WeiCheng14159/VSD_CNN_accelerator/VSD_2021/src/data_array_wrapper.sv

`ifndef __DATAARY__
`define __DATAARY__
module data_array_wrapper (
    input CK,
    input CS,
    input OE,
    input [15:0] WEB,
    input [5:0] A,
    input [127:0] DI,
    output [127:0] DO
);

  data_array i_data_array (
      .A0   (A[0]),
      .A1   (A[1]),
      .A2   (A[2]),
      .A3   (A[3]),
      .A4   (A[4]),
      .A5   (A[5]),
      .DO0  (DO[0]),
      .DO1  (DO[1]),
      .DO2  (DO[2]),
      .DO3  (DO[3]),
      .DO4  (DO[4]),
      .DO5  (DO[5]),
      .DO6  (DO[6]),
      .DO7  (DO[7]),
      .DO8  (DO[8]),
      .DO9  (DO[9]),
      .DO10 (DO[10]),
      .DO11 (DO[11]),
      .DO12 (DO[12]),
      .DO13 (DO[13]),
      .DO14 (DO[14]),
      .DO15 (DO[15]),
      .DO16 (DO[16]),
      .DO17 (DO[17]),
      .DO18 (DO[18]),
      .DO19 (DO[19]),
      .DO20 (DO[20]),
      .DO21 (DO[21]),
      .DO22 (DO[22]),
      .DO23 (DO[23]),
      .DO24 (DO[24]),
      .DO25 (DO[25]),
      .DO26 (DO[26]),
      .DO27 (DO[27]),
      .DO28 (DO[28]),
      .DO29 (DO[29]),
      .DO30 (DO[30]),
      .DO31 (DO[31]),
      .DO32 (DO[32]),
      .DO33 (DO[33]),
      .DO34 (DO[34]),
      .DO35 (DO[35]),
      .DO36 (DO[36]),
      .DO37 (DO[37]),
      .DO38 (DO[38]),
      .DO39 (DO[39]),
      .DO40 (DO[40]),
      .DO41 (DO[41]),
      .DO42 (DO[42]),
      .DO43 (DO[43]),
      .DO44 (DO[44]),
      .DO45 (DO[45]),
      .DO46 (DO[46]),
      .DO47 (DO[47]),
      .DO48 (DO[48]),
      .DO49 (DO[49]),
      .DO50 (DO[50]),
      .DO51 (DO[51]),
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
      .DI114(DI[114]),
      .DI115(DI[115]),
      .DI116(DI[116]),
      .DI117(DI[117]),
      .DI118(DI[118]),
      .DI119(DI[119]),
      .DI120(DI[120]),
      .DI121(DI[121]),
      .DI122(DI[122]),
      .DI123(DI[123]),
      .DI124(DI[124]),
      .DI125(DI[125]),
      .DI126(DI[126]),
      .DI127(DI[127]),
      .CK   (CK),
      .WEB0 (WEB[0]),
      .WEB1 (WEB[1]),
      .WEB2 (WEB[2]),
      .WEB3 (WEB[3]),
      .WEB4 (WEB[4]),
      .WEB5 (WEB[5]),
      .WEB6 (WEB[6]),
      .WEB7 (WEB[7]),
      .WEB8 (WEB[8]),
      .WEB9 (WEB[9]),
      .WEB10(WEB[10]),
      .WEB11(WEB[11]),
      .WEB12(WEB[12]),
      .WEB13(WEB[13]),
      .WEB14(WEB[14]),
      .WEB15(WEB[15]),
      .OE   (OE),
      .CS   (CS)
  );

endmodule
`endif
