WeiCheng14159/VSD_CNN_accelerator/EPU_verify/mem/inout_16b_sram/SUMA180_32768X16X1BM8_rtl.sv

module SUMA180_32768X16X1BM8 (A0,A1,A2,A3,A4,A5,A6,A7,A8,A9,A10,A11,A12,A13,A14,
                              DO0,DO1,DO2,DO3,DO4,DO5,DO6,DO7,DO8,DO9,DO10,
                              DO11,DO12,DO13,DO14,DO15,DI0,DI1,DI2,DI3,
                              DI4,DI5,DI6,DI7,DI8,DI9,DI10,DI11,DI12,DI13,
                              DI14,DI15,CK,WEB,OE, CS);

  output     DO0,DO1,DO2,DO3,DO4,DO5,DO6,DO7,DO8,
             DO9,DO10,DO11,DO12,DO13,DO14,DO15;
  input      DI0,DI1,DI2,DI3,DI4,DI5,DI6,DI7,DI8,
             DI9,DI10,DI11,DI12,DI13,DI14,DI15;
  input      A0,A1,A2,A3,A4,A5,A6,A7,A8,A9,A10,A11,A12,A13,A14;
  input      WEB;                                  
  input      CK;                                      
  input      CS;                                      
  input      OE;                                      
  parameter  AddressSize          = 15;               
  parameter  Bits                 = 16;                
  parameter  Words                = 32768;            
  parameter  Bytes                = 1;                
  logic      [Bits-1:0]           Memory [Words-1:0];     

  logic      [Bytes*Bits-1:0]     DI;                
  logic      [Bytes*Bits-1:0]     DO;                
  logic      [Bytes*Bits-1:0]     latched_DO;                
  logic      [AddressSize-1:0]    A;                 
  assign     DO0                  = DO[0];
  assign     DO1                  = DO[1];
  assign     DO2                  = DO[2];
  assign     DO3                  = DO[3];
  assign     DO4                  = DO[4];
  assign     DO5                  = DO[5];
  assign     DO6                  = DO[6];
  assign     DO7                  = DO[7];
  assign     DO8                  = DO[8];
  assign     DO9                  = DO[9];
  assign     DO10                 = DO[10];
  assign     DO11                 = DO[11];
  assign     DO12                 = DO[12];
  assign     DO13                 = DO[13];
  assign     DO14                 = DO[14];
  assign     DO15                 = DO[15];

  assign     DI[0]                = DI0;
  assign     DI[1]                = DI1;
  assign     DI[2]                = DI2;
  assign     DI[3]                = DI3;
  assign     DI[4]                = DI4;
  assign     DI[5]                = DI5;
  assign     DI[6]                = DI6;
  assign     DI[7]                = DI7;
  assign     DI[8]                = DI8;
  assign     DI[9]                = DI9;
  assign     DI[10]               = DI10;
  assign     DI[11]               = DI11;
  assign     DI[12]               = DI12;
  assign     DI[13]               = DI13;
  assign     DI[14]               = DI14;
  assign     DI[15]               = DI15;

  assign     A[0]                 = A0;
  assign     A[1]                 = A1;
  assign     A[2]                 = A2;
  assign     A[3]                 = A3;
  assign     A[4]                 = A4;
  assign     A[5]                 = A5;
  assign     A[6]                 = A6;
  assign     A[7]                 = A7;
  assign     A[8]                 = A8;
  assign     A[9]                 = A9;
  assign     A[10]                = A10;
  assign     A[11]                = A11;
  assign     A[12]                = A12;
  assign     A[13]                = A13;
  assign     A[14]                = A14;

  always_ff @(posedge CK)
  begin
    if (CS)
    begin
      if (~WEB)
      begin
        Memory[A] <= DI;
        latched_DO <= DI;
      end
      else
      begin
        latched_DO <= Memory[A];
      end
    end
  end

  always_comb
  begin
    DO = (OE)? latched_DO: {(Bytes*Bits){1'bz}};
  end

endmodule
