WeiCheng14159/VSD_CNN_accelerator/VSD_2021/src/Interface/inf_IF_ID.sv

`ifndef __IFID__
`define __IFID__ 
`include "../../include/CPU_def.svh"

interface inf_IF_ID;
  logic [`DATA_BITS-1:0] inst;
  logic [`ADDR_BITS-1:0] pc;

  modport IF2ID(output inst, pc);
  modport ID2IF(input inst, pc);

endinterface : inf_IF_ID
`endif
