WeiCheng14159/VSD_CNN_accelerator/VSD_2021/src/ROM_wrapper.sv

`include "../include/AXI_define.svh"
`include "../include/CPU_def.svh"
`include "./Interface/inf_Slave.sv"

module ROM_wrapper (
    input                                      clk,
    rst,
           inf_Slave.S2AXIin                   s2axi_i,
           inf_Slave.S2AXIout                  s2axi_o,
    input                     [`DATA_BITS-1:0] ROM_out_i,
    output logic                               ROM_read_o,
    output logic                               ROM_en_o,
    output logic              [          11:0] ROM_addr_o
);

  parameter IDLE = 2'h0, R_CH = 2'h1;
  logic [1:0] STATE, NEXT;
  // Handshake
  logic arhns, rhns;
  logic rdfin;

  // 
  logic [`AXI_IDS_BITS  -1:0] arids, awids;
  logic [`AXI_LEN_BITS  -1:0] arlen;
  logic [`AXI_BURST_BITS-1:0] arburst;
  logic [               11:0] raddr;
  logic [                1:0] rom_off;
  logic [  `AXI_LEN_BITS-1:0] cnt;

  // Handshake
  assign arhns = s2axi_i.arvalid & s2axi_o.arready;
  assign rhns  = s2axi_o.rvalid & s2axi_i.rready;
  assign rdfin = s2axi_o.rlast & rhns;

  always_ff @(posedge clk or negedge rst) begin
    if (~rst) cnt <= `AXI_LEN_BITS'h0;
    else if (rhns) cnt <= rdfin ? `AXI_LEN_BITS'h0 : cnt + `AXI_LEN_BITS'h1;
  end

  assign s2axi_o.rlast = cnt == arlen;
  // assign s2axi_o.rlast = rlast;
  assign s2axi_o.rresp = `AXI_RESP_OKAY;
  assign s2axi_o.bresp = `AXI_RESP_SLVERR;
  assign s2axi_o.rdata = ROM_out_i;
  assign s2axi_o.rid   = arids;
  assign s2axi_o.bid   = `AXI_IDS_BITS'h0;

  // Sample
  always_ff @(posedge clk or negedge rst) begin
    if (~rst) begin
      raddr <= 12'h0;
      arids <= `AXI_IDS_BITS'h0;
      arlen <= `AXI_LEN_BITS'h0;
    end else begin
      raddr <= arhns ? s2axi_i.araddr[13:2] : raddr;
      arids <= arhns ? s2axi_i.arid : arids;
      arlen <= arhns ? s2axi_i.arlen : arlen;
    end
  end

  always_ff @(posedge clk or negedge rst) begin
    STATE <= ~rst ? IDLE : NEXT;
  end
  always_comb begin
    case (STATE)
      IDLE:    NEXT = arhns ? R_CH : IDLE;
      R_CH:    NEXT = (rdfin & arhns) ? R_CH : (rdfin ? IDLE : R_CH);
      default: NEXT = STATE;
    endcase
  end


  assign s2axi_o.awready = 1'b0;
  assign s2axi_o.wready = 1'b0;
  assign s2axi_o.bvalid = 1'b0;
  assign s2axi_o.arready = STATE == IDLE;
  assign s2axi_o.rvalid = STATE == R_CH;

  assign ROM_en_o = 1'b1;
  assign ROM_read_o = STATE == R_CH | s2axi_i.arvalid;

  assign rom_off = ~|cnt[1:0] ? (rhns ? cnt[1:0] + 2'h1 : cnt[1:0]) : cnt[1:0] + 2'h1;

  always_comb begin
    case (STATE)
      IDLE:    ROM_addr_o = s2axi_i.araddr[13:2];
      R_CH:    ROM_addr_o = {raddr[11:2], rom_off};
      default: ROM_addr_o = 12'h0;
    endcase
  end

endmodule
