WeiCheng14159/VSD_CNN_accelerator/VSD_2021/src/CPU/IF_S.sv

`include "../../include/CPU_def.svh"
`include "../Interface/inf_IF_ID.sv"

module IF_S (
    /* Debug */
    output logic [31:0] debug_pc, debug_inst,

    input                     clk, rst,
    inf_IF_ID.IF2ID           if2id_o,
    input                     ifid_en_i,
    input                     stall_i, flush_i,
    input  [`DATA_BITS  -1:0] inst_i,
    output [`ADDR_BITS  -1:0] inst_pc_o,
    input  [`ADDR_BITS  -1:0] exe_pc_imm_i, exe_pc_aluout_i,
    input  [`BRANCH_BITS-1:0] exe_branch_ctrl_i,
    input                     exe_zero_flag_i,
    // CSR
    input                     csr_int_i,
    input                     csr_mret_i,
    input  [`ADDR_BITS  -1:0] csr_pc_i, csr_mretpc_i
);
    logic [`ADDR_BITS-1:0] pc_in, pc_out, pc_outadd4;
    assign pc_outadd4 = pc_out + 32'h4;
    // Branch Ctrl
    always @(*) begin
        if (csr_mret_i)
            pc_in = csr_mretpc_i;
        else if (csr_int_i) 
            pc_in = csr_pc_i;
        else begin
            case (exe_branch_ctrl_i)
                `BRANCH_NEXT : pc_in = pc_outadd4;
                `BRANCH_BEQ  : pc_in = exe_zero_flag_i ? pc_outadd4 : exe_pc_imm_i;
                `BRANCH_JAL  : pc_in = exe_pc_imm_i;
                `BRANCH_JALR : pc_in = {exe_pc_aluout_i[31:1], 1'b0};
            endcase
        end
    end
    // PC
    assign inst_pc_o = pc_out;
    always @(posedge clk or posedge rst) begin
        if (rst)             pc_out <= `ADDR_BITS'h0;
        // else if (ifid_en_i) pc_out <= pc_out;
        else if (ifid_en_i & stall_i) pc_out <= pc_out;
        else if (ifid_en_i)           pc_out <= pc_in;
        // else                 pc_out <= pc_in;
    end	
    always @(posedge clk or posedge rst) begin
        if (rst)             if2id_o.pc <= `ADDR_BITS'h0;
        // else if (~ifid_en_i) if2id_o.pc <= if2id_o.pc;
        else if (ifid_en_i & stall_i)    if2id_o.pc <= if2id_o.pc;
        else if (ifid_en_i)              if2id_o.pc <= pc_out;     
    end
    // Inst
    always @(posedge clk or posedge rst) begin
        if (rst)             if2id_o.inst <= `DATA_BITS'h0;
        // else if (~ifid_en_i) if2id_o.inst <= if2id_o.inst;
        else if (ifid_en_i & flush_i)    if2id_o.inst <= `DATA_BITS'h0;
        else if (ifid_en_i & stall_i)    if2id_o.inst <= if2id_o.inst;
        else if (ifid_en_i)              if2id_o.inst <= inst_i;
    end


// /*
// {{{ Debug (id)
assign debug_pc   = if2id_o.pc;
assign debug_inst = if2id_o.inst;
// }}}
// */
endmodule
