WeiCheng14159/VSD_CNN_accelerator/VSD_2021/sim/conv_all/main.c

unsigned int *copy_addr; // = &_test_start;
unsigned int copy_count = 0;
const unsigned int sensor_size = 64;
volatile unsigned int *sensor_addr          = (int *) 0x10000000;
volatile unsigned int *epu_in_buff_addr     = (int *) 0x50000000;
volatile unsigned int *epu_out_buff_addr    = (int *) 0x60000000;
volatile unsigned int *epu_weight_buff_addr = (int *) 0x70000000;
volatile unsigned int *epu_bias_buff_addr   = (int *) 0x71000000;
volatile unsigned int *epu_param_buff_addr  = (int *) 0x72000000;
volatile unsigned int *epu_ctrl_addr        = (int *) 0x80000000;
volatile unsigned int *epu_w8_l_addr        = (int *) 0x81000000;
volatile unsigned int *epu_w8_u_addr        = (int *) 0x82000000;

extern void dma_move(unsigned int *source, unsigned int *dest, unsigned int quantity);

enum EPU_MODE {
    IDLE      = 0x1,
    CONV_1x1  = 0x2,
    MAX_POOL  = 0x4,
    CONV_3x3  = 0x8
};

// void dma_move(int *source, int *dest, int quantity);
void cpu_move(int *source, int *dest, int quantity);

void cpu_move(int *source, int *dest, int quantity) {
  int i;
  for (i = 0; i < quantity; i++) {
    dest[i] = source[i];
  }
};

int main(void) {
  extern unsigned int _test_start;
/* EPU data address */
  /* Conv0 */
    // input data address
    extern unsigned int __in8_conv0_start;
    extern unsigned int __in8_conv0_end;
    extern unsigned int __in8_conv0_data_in_dram_start;
    // w2 data address
    extern unsigned int __w2_conv0_start;
    extern unsigned int __w2_conv0_end;
    extern unsigned int __w2_conv0_data_in_dram_start;
    // bias data address
    extern unsigned int __bias_conv0_start;
    extern unsigned int __bias_conv0_end;
    extern unsigned int __bias_conv0_data_in_dram_start;
    // param data address 
    extern unsigned int __param_conv0_start;
    extern unsigned int __param_conv0_end;
    extern unsigned int __param_conv0_data_in_dram_start;
  /* Conv1 */
    // w2 data address
    extern unsigned int __w2_conv1_start;
    extern unsigned int __w2_conv1_end;
    extern unsigned int __w2_conv1_data_in_dram_start;
    // bias data address
    extern unsigned int __bias_conv1_start;
    extern unsigned int __bias_conv1_end;
    extern unsigned int __bias_conv1_data_in_dram_start;
    // param data address 
    extern unsigned int __param_conv1_start;
    extern unsigned int __param_conv1_end;
    extern unsigned int __param_conv1_data_in_dram_start;
  /* Pool0 */
    // param data address 
    extern unsigned int __param_pool0_start;
    extern unsigned int __param_pool0_end;
    extern unsigned int __param_pool0_data_in_dram_start;
    // output data address 
    extern unsigned int __out8_pool0_start;
    extern unsigned int __out8_pool0_end;
    extern unsigned int __out8_pool0_data_in_dram_start;

  int quantity;
  int epu_mode;
  unsigned int w8;

/* conv0 */
  // Move input data
  quantity = (&__in8_conv0_end - &__in8_conv0_start) - 1;
  dma_move(&__in8_conv0_data_in_dram_start, &__in8_conv0_start, quantity);
  // Move param data
  quantity = (&__param_conv0_end - &__param_conv0_start) - 1;
  dma_move(&__param_conv0_data_in_dram_start, &__param_conv0_start, quantity);
  // Move w2 data
  quantity = (&__w2_conv0_end - &__w2_conv0_start) - 1;
  dma_move(&__w2_conv0_data_in_dram_start, &__w2_conv0_start, quantity);
  // Move bias data
  quantity = (&__bias_conv0_end - &__bias_conv0_start) - 1;
  dma_move(&__bias_conv0_data_in_dram_start, &__bias_conv0_start, quantity);

  // Load W8 into EPU
  w8 = 0x08FAE800;
  *epu_w8_l_addr = w8;
  *epu_w8_u_addr = w8 >> 16;

  // Send EPU control signal
  epu_mode = CONV_3x3;
  *epu_ctrl_addr = 0x1 | (epu_mode << 1);
  asm("wfi");

/* conv1 */
  // Move param data
  quantity = (&__param_conv1_end - &__param_conv1_start) - 1;
  dma_move(&__param_conv1_data_in_dram_start, &__param_conv0_start, quantity);
  // Move w2 data
  quantity = (&__w2_conv1_end - &__w2_conv1_start) - 1;
  dma_move(&__w2_conv1_data_in_dram_start, &__w2_conv0_start, quantity);
  // Move bias data
  quantity = (&__bias_conv1_end - &__bias_conv1_start) - 1;
  dma_move(&__bias_conv1_data_in_dram_start, &__bias_conv0_start, quantity);

  // Load W8 into EPU
  w8 = 0x0EE6C600;
  *epu_w8_l_addr = w8;
  *epu_w8_u_addr = w8 >> 16;

  // Send EPU control signal
  epu_mode = CONV_1x1;
  *epu_ctrl_addr = 0x1 | (epu_mode << 1) | (0x1 << 5);
  asm("wfi");

/* pool0 */
  // Move param data
  quantity = (&__param_pool0_end - &__param_pool0_start) - 1;
  dma_move(&__param_pool0_data_in_dram_start, &__param_conv0_start, quantity);
  
  // Send EPU control signal
  epu_mode = MAX_POOL;
  *epu_ctrl_addr = 0x1 | (epu_mode << 1);
  asm("wfi");

  // Move output data back to DRAM
  quantity = (&__out8_pool0_end - &__out8_pool0_start) - 1;
  dma_move(&__out8_pool0_start, &_test_start, quantity);

  return 0;
}
