WeiCheng14159/VSD_CNN_accelerator/(commit log)

2022-01-03 feat-Add DMA for testing
    - Not working WIP
    [DMA.sv]
2022-01-03 fix-Modify B_ch.sv
    - Pass superlint
    [B_ch.sv]
2022-01-04 feat-Use sv interface to connect BRAMs
    - Use systemverilog interface to connect BRAMs and compute units in
    testbench.
    - Other minor fix
    [conv.sv, conv_tb.sv]
2022-01-04 fix-Include bram interface for synthesis
    [conv.sv]
2022-01-04 fix-Change conv.v -> conv.sv
    [conv.sv]
2022-01-04 fix-Remove interface in tb
    [conv.sv, conv_tb.sv]
2022-01-04 fix-Remove FSDB_ALL that always gen waveform
    [conv_tb.sv]
2022-01-05 fix-Use macro definition for all bus width
    - For better understanding
    [conv.sv]
2022-01-07 fix-DMA_pass0_pass2
    - pass rtl0 and rtl2
    [AR_ch.sv, AW_ch.sv, AXI.sv, Arbiter.sv, B_ch.sv, CPU.sv, DMA.sv, DMA_master.sv]
2022-01-09 fix-Design DMA
    - Add isr.S
    - Pass rtl0, rtl2
    [AR_ch.sv, AW_ch.sv, AXI.sv, Arbiter.sv, B_ch.sv, CPU.sv, CPU_wrapper.sv, CSR.sv]
2022-01-10 fix-Rename CONV.sv to conv.sv
    [conv.sv]
2022-01-10 fix-testbench doesn't read all hex files
    - tb should fully read all hex files
    [conv_tb.sv]
2022-01-10 fix-Check all data in tb
    [conv_tb.sv]
2022-01-10 fix-Check first 2000 data by default
    [conv_tb.sv]
2022-01-10 fix-Change in/out r/w bit width to 16
    [conv_tb.sv]
2022-01-10 Pass superlint
    - remove extra wire
2022-01-10 Modify DMA
    - much faster than the previous version
2022-01-10 fix-Move interface definition to include folder
    [sp_ram_intf.sv]
2022-01-11 fix-Change InOut RAM block ram name
    [InOut_SRAM_384k.sv]
2022-01-11 fix-Connect all rams from WEB signal
    [Bias_SRAM_2k.sv, InOut_SRAM_384k.sv, Weight_SRAM_180k.sv]
2022-01-11 fix-Tenstbench tolerate +-1 error
    [conv_tb.sv]
2022-01-11 fix-Change of SRAM interface
    - Actually replace the old SRAM model with the new one
    [Bias_SRAM_2k.sv, InOut_SRAM_384k.sv, Param_SRAM_16B.sv, Weight_SRAM_180k.sv, conv.sv, conv_tb.sv, sp_ram_intf.sv]
2022-01-11 fix-Conv accelerator read param correctly
    - Adapt to the change of new RAM model
    [conv.sv]
2022-01-11 fix-Load bias correctly
    - Adapt to the new memory model
    [conv.sv]
2022-01-11 fix-Dump waveform of interface
    [conv_tb.sv]
2022-01-11 fix-Output checking in testbench is wrong
    - Forget to compute the value of "slice"
    [conv_tb.sv]
2022-01-12 feat-Add switching func between 3x3 and 1x1 kernel
2022-01-12 feat-Add max pooling unit to module conv
    - Add max pooling unit & bus switcher in conv module
2022-01-12 fix-tb adapt to the port of conv module
    [conv_tb.sv]
2022-01-12 fix-testbench should stop if MAX cyc reached
    - tsstbench should stop when max amount of cycles are reached.
    - Create a new "checking" task in tb for testing.
    [conv_tb.sv]
2022-01-12 fix-Test first 2000 mem loc only by default
    [conv_tb.sv]
2022-01-12 fix-Only read bias, weight from .hex if needed
    - Maxpooling unit doesn't need bias and weight. Don't load them in tb
    [conv_tb.sv]
2022-01-12 fix-Unify time scale
    - rtl sim 1ns/1ns
    - gate level sim 1ns/10 ps
    - apr sim 1ns/10 ps
    [conv_tb.sv]
2022-01-12 fix-Unify time scale for faster sim
    [conv_tb.sv]
2022-01-12 fix-Check only first 2000 mem location by default
    [conv_tb.sv]
2022-01-13 fix-Include interface file for synthesize
    [conv.sv]
2022-01-13 fix-Include files in tb for synthesis
    [conv_tb.sv]
2022-01-14 Pass hw4 rtl1
    - with 6 slave (DMA, EPU_wrapper)
    - without setDMA
    - sol: modify L1C_data.sv (CHK state)
2022-01-15 fix-Change include file path
    [Bias_SRAM_2k.sv, InOut_SRAM_384k.sv, Param_SRAM_16B.sv, Weight_SRAM_180k.sv]
2022-01-15 fix-Update single port ran interface
    [sp_ram_intf.sv]
2022-01-15 fix-Buffer wrapper move to right folder for syn
    [Bias_SRAM_2k.sv, Bias_wrapper.sv, InOut_SRAM_384k.sv, Input_wrapper.sv, Output_wrapper.sv, Param_SRAM_16B.sv, Param_wrapper.sv, SRAM_16b_32768w_64k.sv]
2022-01-15 fix-Redesign EPU control register to avoid latch
    [EPU_wrapper.sv]
2022-01-15 Modify L1C_data.sv
    - pass rtl1 with sensor and DMA
2022-01-15 feat-Connect EPU interrupt
2022-01-15 fix-Connect read valid signal in EPU buffer wrappers
    - Bias, Weight, Param wrapper are write only
    - Input, Output wrapper are read/writable
    [Bias_wrapper.sv, Input_wrapper.sv, Output_wrapper.sv, Param_wrapper.sv, Weight_wrapper.sv]
2022-01-15 fix-Remove unused signal in EPU interface
    [inf_EPUIN.sv]
2022-01-15 fix-Seperate EPU interface signal and AXI signal
    [EPU_wrapper.sv]
2022-01-15 fix-Burst signal not init
    [EPU_wrapper.sv]
2022-01-15 fix-EPU system reset is active high
    [EPU_wrapper.sv]
2022-01-15 fix-Connect EPU interrupt to CPU
    [top.sv]
2022-01-15 fix-Typo in signal width
    [EPU_wrapper.sv]
2022-01-15 fix-Change EPU_wrapper signal to SV enum
    [EPU_wrapper.sv]
2022-01-17 Backup
    - Add counter for DRAM in DMA
2022-01-17 Pass rtl0, rtl1
    - copy without DMA
    - interrput collision
    [DMA.sv, DMA_master.sv, DRAM_wrapper.sv, PLIC.sv, main.c]
2022-01-17 feat-Update boot.c code
    - Remove old unused code and use DMA for data movement.
2022-01-17 feat-Add DMA function in main function
2022-01-17 feat-Use DMA for EPU data movement
2022-01-17 Modify PLIC
    - latch interrupt
2022-01-17 fix-Write signal should be active low when not connected
    - Write signal (active low) should be inactive if EPU is not connected
    to each buffer wrapper
    [Conv_bus_switcher.sv]
2022-01-17 fix-Param SRAM should have matching addr size
    - Reduce size of address width
    [Param_SRAM_16B.sv]
2022-01-18 feat-Add two type of data moving method
    - Move data with DMA or with CPU.
    - Move input/param/weight/bias data using DMA in main function
2022-01-18 feat-Param buffer wrapper address has wrong width
    [Param_SRAM_16B.sv]
2022-01-18 fix-Byte_off signal without reset signal
    [DRAM_wrapper.sv]
2022-01-18 Backup
    - Modify PLIC (WIP)
    - Pass rtl0, rtl1
    - rtl1 (copy without DMA)
    - interrupt collision
    [Bias_SRAM_2k.sv, Bias_wrapper.sv, CPU.sv, ConvAcc.sv, ConvAcc_wrapper.sv, Conv_1x1.sv, Conv_3x3.sv, Conv_bus_switcher.sv]
2022-01-19 Modify communication between master and slave
    - With DMA (ren, wen)
2022-01-19 fix-Change active low signal to tailing "n"
    [Conv_1x1.sv, Conv_3x3.sv, Max_pool.sv]
2022-01-19 feat-Write assembly for first layer conv0
2022-01-19 feat-Add reset condition for EPU registers
    - Registers reset if conv is finish
    [EPU_wrapper.sv]
2022-01-19 fix-Use up-to-date address signal for register write
    [EPU_wrapper.sv]
2022-01-19 Modify DMA transfer
2022-01-19 DRAM_wrapper need to fix
    - need to check same row
    [DMA_master.sv, DRAM_wrapper.sv, EPU_wrapper.sv, Input_wrapper.sv, inf_EPUIN.sv, main.c, top_tb.sv]
2022-01-20 fix-conv testbench checking
    - testbench check right amount of data if the number of data needs to be
    checked is less than 2000
    [top_tb.sv]
2022-01-20 feat-Finalalize conv0 assembly code
2022-01-20 fix-Add new signal in EPU interface
    [inf_EPUIN.sv]
2022-01-20 fix-Use C enum in main.c for easier coding
    [main.c]
2022-01-20 fix-Simplify the decoding of EPU mapped address
    [EPU_wrapper.sv]
2022-01-20 fix-DRAM wrapper syntax err
    [DRAM_wrapper.sv]
2022-01-20 fix-EPU SRAM wrappers synthesis fix
    [Bias_SRAM_2k.sv, InOut_SRAM_384k.sv, Param_SRAM_16B.sv, Weight_SRAM_180k.sv]
2022-01-20 fix-Change EPU control reg mapped address
    [EPU_wrapper.sv, main.c]
2022-01-20 fix-Connect reset signal to memory
    [Input_wrapper.sv, Output_wrapper.sv, Param_wrapper.sv, Weight_wrapper.sv]
2022-01-20 fix-Change priority encoding if-else to case
    [Bias_wrapper.sv, Conv_bus_switcher.sv, Input_wrapper.sv, Output_wrapper.sv, Weight_wrapper.sv]
2022-01-20 Modify DRAM_wrapper
    - fix overflow in col
    [DMA_master.sv, DRAM_wrapper.sv]
2022-01-21 Modify DRAM_wrapper
    - get correct data
    [DRAM_wrapper.sv, EPU_wrapper.sv]
2022-01-21 fix-Optimize EPU wrapper & change EPU API
    - Current cycle = 11 ns
    [EPU_wrapper.sv, main.c]
2022-01-21 fix-Update max pooling module
    [Max_pool.sv]
2022-01-21 fix-Make testbench golden array larger
    [top_tb.sv]
2022-01-25 fix-Revert to single port mode
    [Bias_SRAM_2k.sv, Bus_switcher.sv, ConvAcc.sv, Conv_1x1.sv, Conv_3x3.sv, InOut_SRAM_384k.sv, InOut_dp_SRAM_384k.sv, Max_pool.sv]
2022-01-25 fix-SP sram & mode use one-hot encoding
    [top_tb.sv]
2022-01-25 fix-Cycle time change to 10
    [top_tb.sv]
2022-01-25 fix-Testbench should dunp single port signals
    [top_tb.sv]
